wdasilvamf/Vocalizador/FinalReport-BrailleVocalizerKebyboard.pdf

Braille vocalization keyboard

Wanderson da Silva Maciel Filho, Maurílio Nunes Vieira
Departamento de Eletrônica/Escola de Engenharia/UFMG - Brazil
Beatriz Fonseca Torres, Regina Célia Passos Ribeiro de Campos
Faculdade de Educação/UFMG - Brazil

### 1. Introduction

This report describes the development of the prototype of a keyboard to aid the literacy of a visually impaired child. One goal is the learning of the Braille symbols for letters and numbers. The user is enrolled in a class with students without visual loss and another goal is the inclusion of the disabled in this class. For this, the keyboard allows not only the sound reproduction of the characters but also the registration and visualization of keystrokes typed for accompaniment of the teacher or of the colleagues (Figure 1).

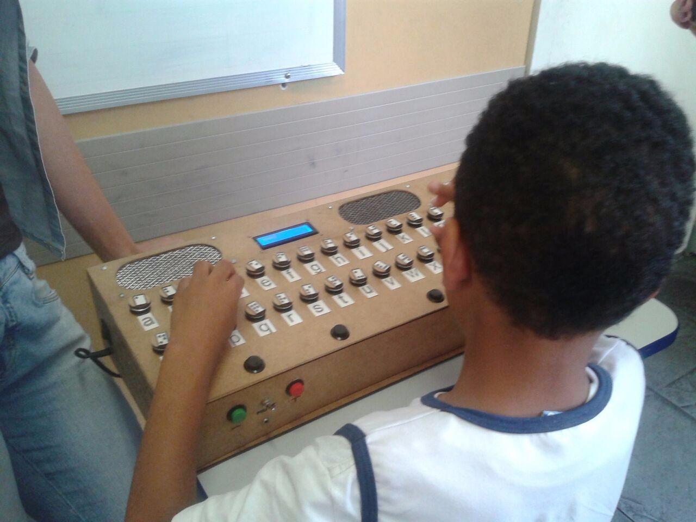
[picture p1: figure]

Figure 1: Visually impaired child using the prototype.

Figure 2 shows details of the prototype. The keys are arranged alphabetical group and numeric groups. Wooden circles with the Braille symbols were glued over the keys. There are two loudspeakers (SP1 and SP2), a liquid crystal display (LCD) and switches to mute and adjust the volume (Vol- and Vol +). The user can also hear the sound of the letters through a headset whose connector is below the mute key. The four black circular buttons on the bottom (unidentified) are reserved for future improvements of the prototype.

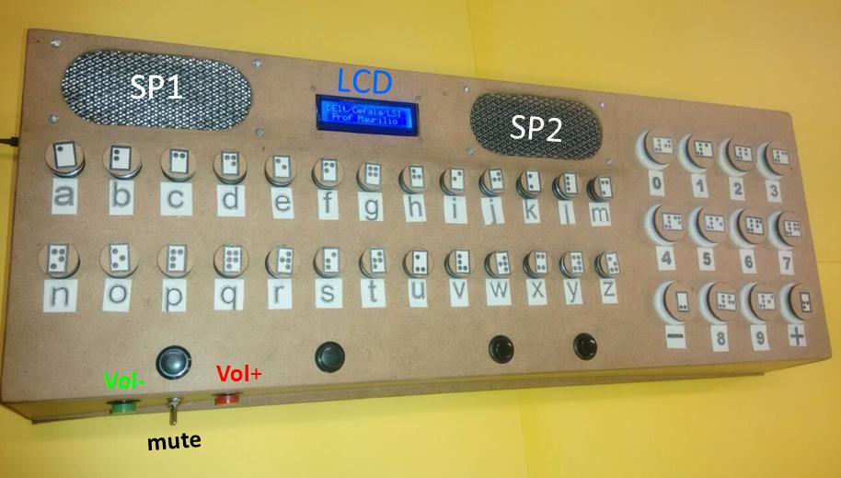
[picture p2: figure]

Figure 2: User interface aspects of the prototype. See details in the text.

Figure 3 presents the inside of the keyboard, highlighting the LDC i2c controller board, the power supplies (AC/DC), and the main control board. This version of the keyboard does not use batteries.

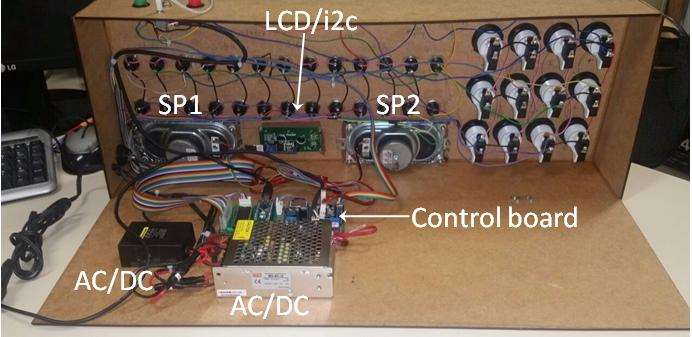
[picture p3: figure]

Figure 3: Interior of the prototype. See text for details.

Figure 4 shows the control board and its main components: the Arduino Nano, the keyboard decoder (CD 4515), the audio processor (DfPlayer mini), and the power amplifier (Pam 8610). Keyboard decoding could have been implemented with obsolete PS2 serial keyboard controllers, but the lack of standardization in the layout of the keyboard matrices motivated the use of a circuit based of the CD 4515, a 4 to 16 decoder.

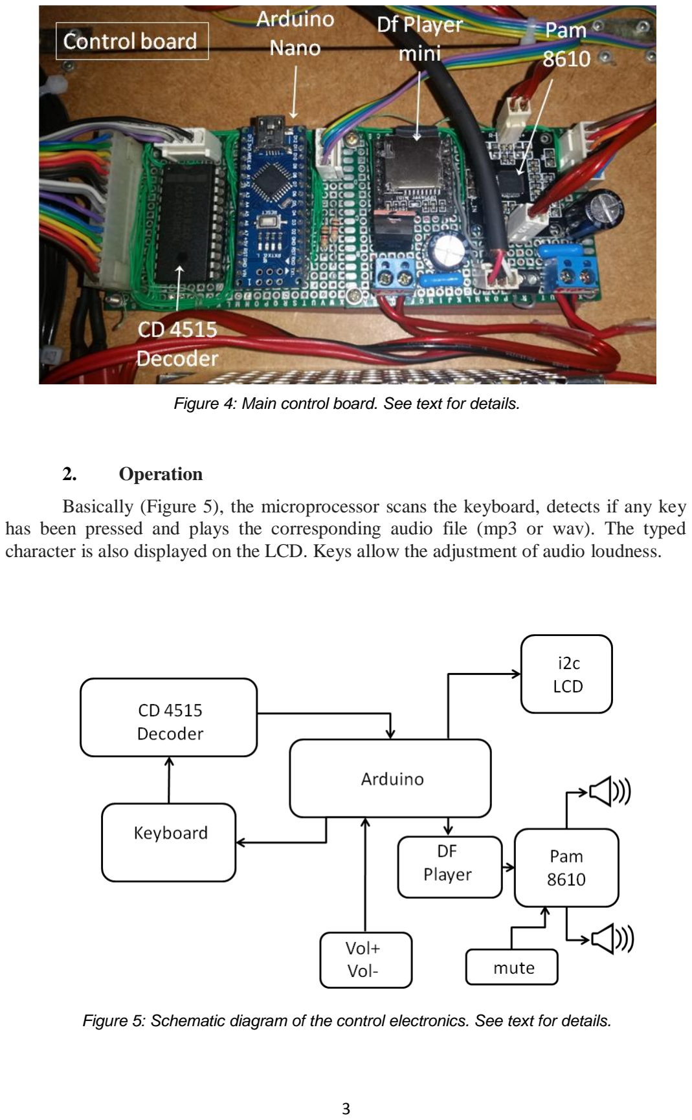
[picture p4: page 3]

Figure 4: Main control board. See text for details.

### 2. Operation

Basically (Figure 5), the microprocessor scans the keyboard, detects if any key has been pressed and plays the corresponding audio file (mp3 or wav). The typed character is also displayed on the LCD. Keys allow the adjustment of audio loudness.

Figure 5: Schematic diagram of the control electronics. See text for details.

### 3. Main control board

### 3.1. Hardware

The schematic diagram of the control board is shown in Figure 6. U2 (Arduino Nano) does the main control of functions. U1 (CD4515) decodes the 4 binary addressing lines (Arduino digital outputs D8 ... D11) into up to 16 individual drive lines (Y0 ... Y15). In the project, 14 outputs (Y0 ... Y13) are used, each line addressing a 3-key group. In this way, Y0 addresses keys A, B or C; Y1 addresses keys D, E, or F, and so on. All alphanumeric keys have momentary contact. The 3-key groups are interconnected by the return lines (Ret1, Ret2 and Ret3), as shown in the schematic diagram. These return lines are Arduino digital inputs that allow the detection, by software, of the key activated in the respective 3-key group.

Once a pressed key is detected, the Arduino software will control the playback of the
audio | files | and | the | display | of | the | characters | on | the | LCD.
A code will be sent to DFPlayer to reproduce the respective file. All audio files have been previously recorded, edited and stored on a MicroSD card housed in the DFPlayer. For complete playback control, volume control functions were performed on Arduino and not using the DFPlayer pins. Audio signals in DFPlayer output have adequate power for earphones, which can be connected to J1, but require amplification for playback on loud speakers so that all students in the class room listen to the sound. This amplification is performed by Pam8610, a 15 W per channel stereo class D amplifier. It was necessary isolated the power supply (12 V × 5 A) of this amplifier to avoid interference with other circuits. Attempts to use filters, etc., were not successful to avoid crosstalk noise. The 9 V × 1 A power source is connected to Arduino, which, in turn, powers the CD451 through the + 5V output. The 9V power source is also connected to U3 (LM 7805 regulator) to provide 5V x 1A (+ 5Vpwr) for the LCD display and the DFPlayer.

Arduino also control the display of characters on the LCD (16 columns x 2 lines). This allows the teacher or colleagues to follow the actions of the user.

3.2.Software

The comments in the source code, attachment, give the details of the hardware control, links to libraries, etc. Direct access to the microprocessor ports (PORTB) resulted in a compact code. The keys are addressed through variables alfabeto [][] and Order [][], which include other keys (ENT, SPC, DEL, ?) aimed at text edition. In the future, resources can be developed to aid to writing learning, such as the management of playing syllables, words, etc.

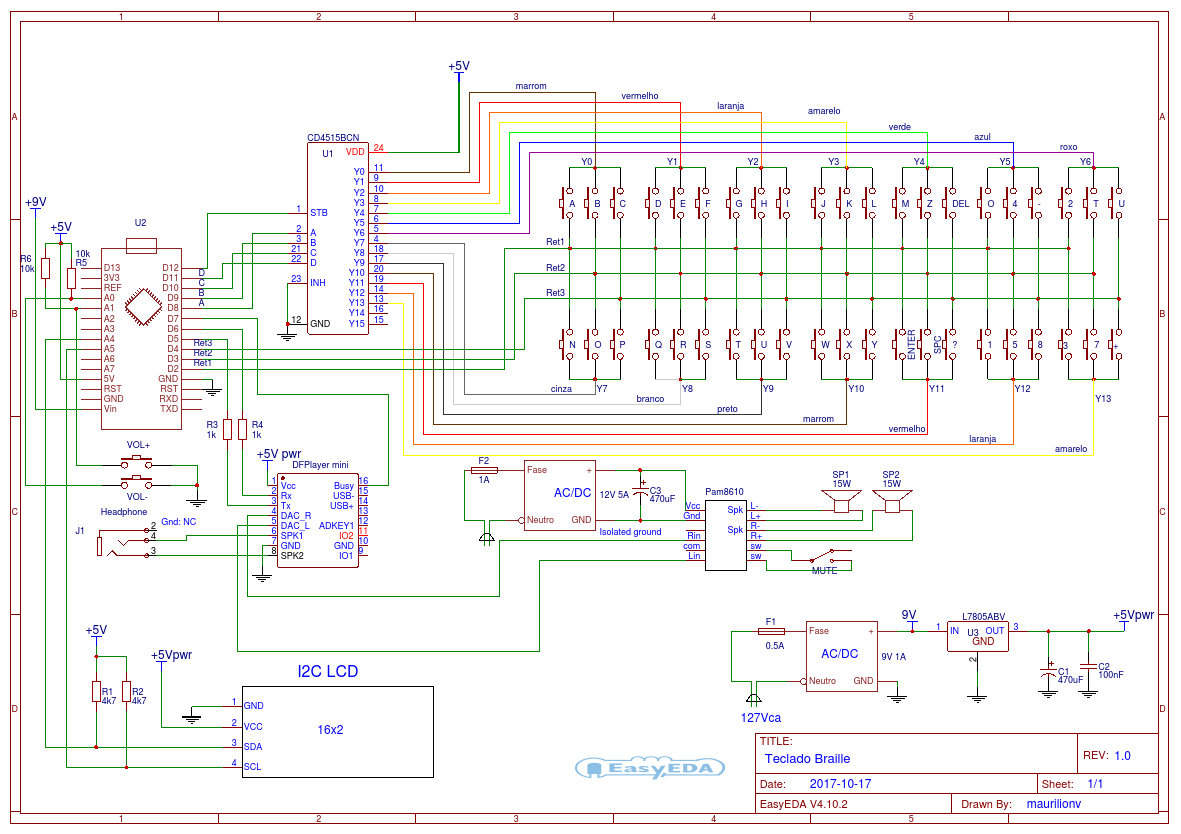
[picture p5: page 5]

5

Figure 6: Detailed schematic diagram

### 4. Source code

Available from

https://drive.google.com/open?id=1iKNauiLZP-CNw-wMV79ck8yiDLUtnyXp

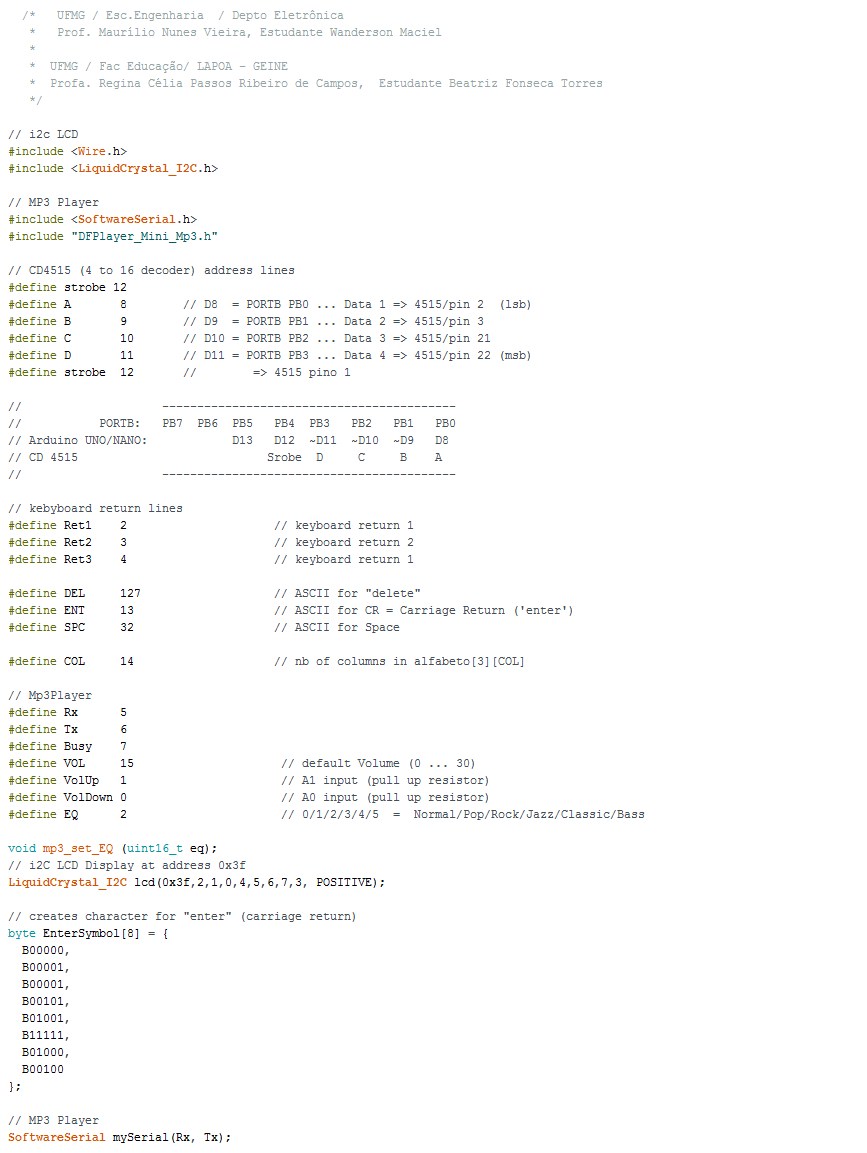
[picture p6: figure]
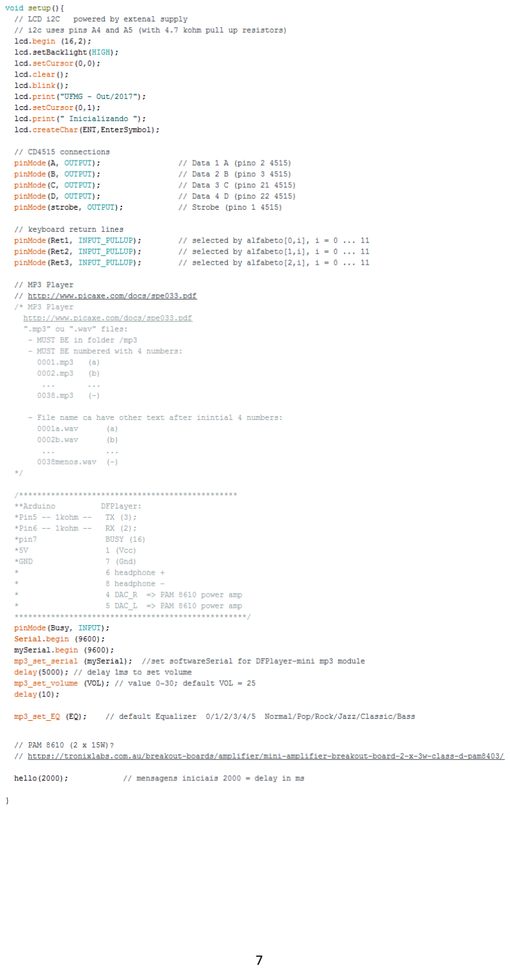
[picture p7: page 7]
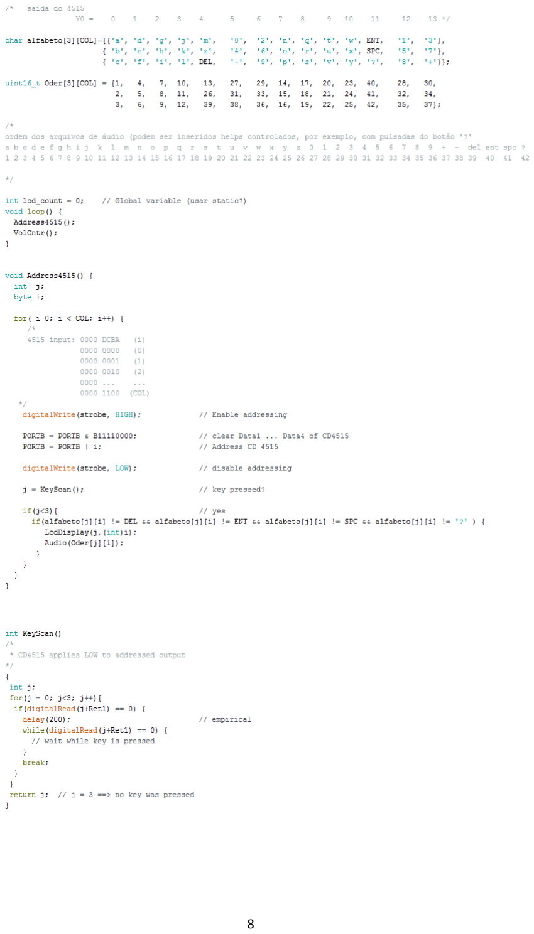
[picture p8: page 8]

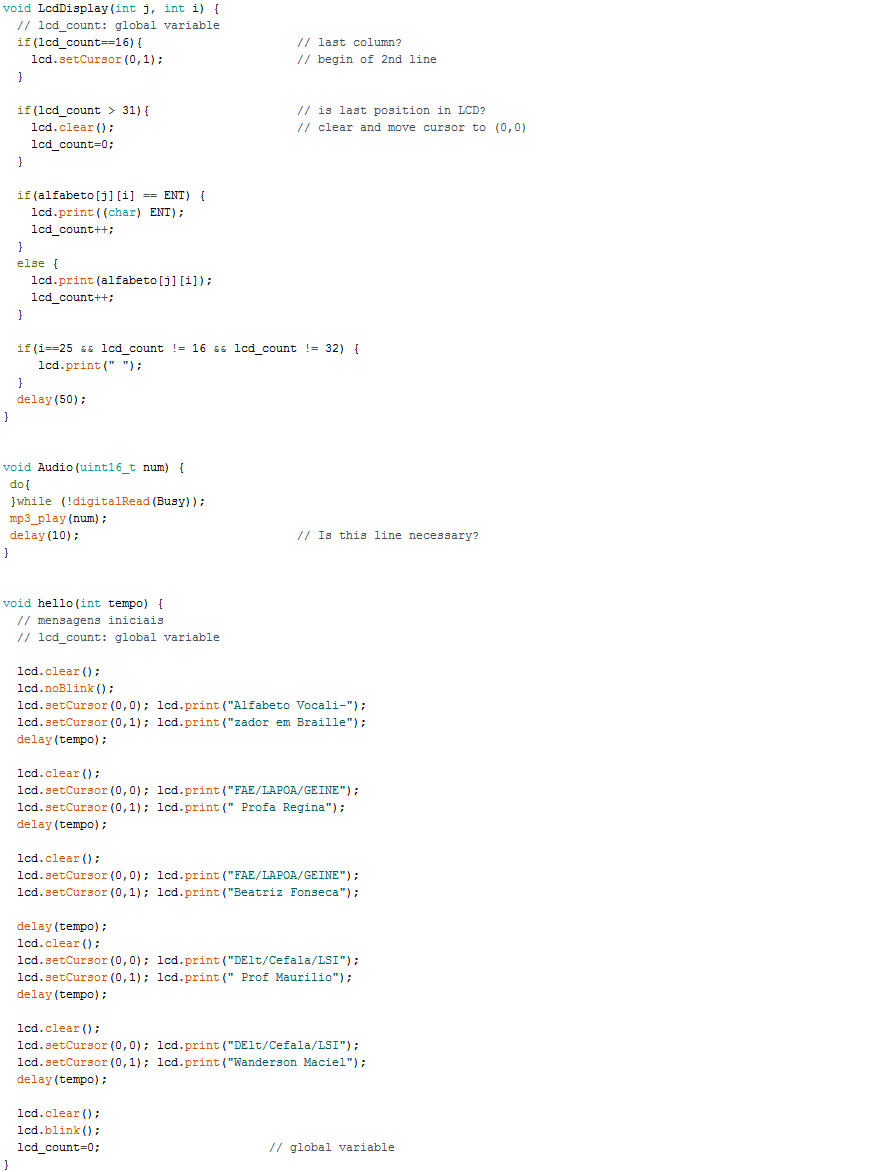
[picture p9: figure]

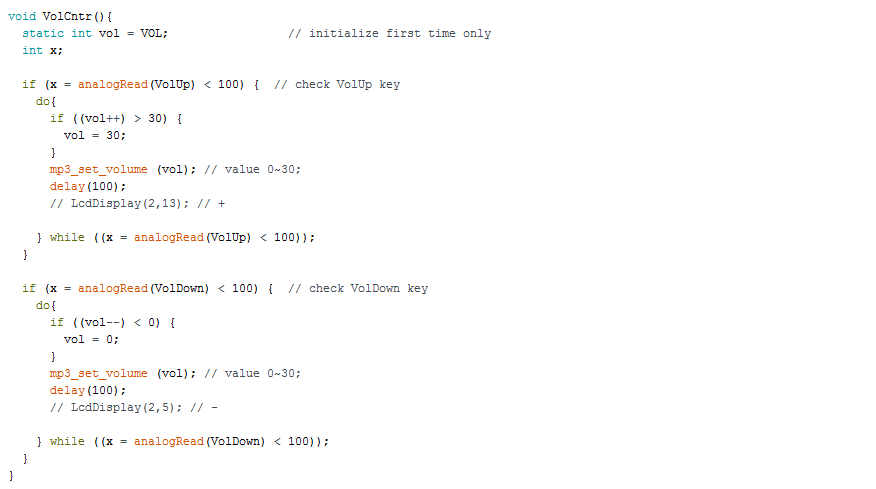
[picture p10: figure]
