wdasilvamf/Vocalizador/RelatorioFinal-vocalizador.pdf

UNIVERSIDADE FEDERAL DE MINAS GERAIS

Teclado Vocalizador Braille

Escola de Engenharia / Depto Eletrônica

LSI - Laboratório de Sistemas Inteligentes

CEFALA – Centro de Estudos da Fala, Música e Linguagem

Estudante Wanderson da Silva Maciel Filho

Prof. Maurílio Nunes Vieira

Faculdade de Educação

LAPOA - Laboratório Interdisciplinar de Produção de Objetos de

Aprendizagem para a pessoa com deficiência

GEINE - Grupo Interdisciplinar de Estudos sobre Educação Inclusiva e

Necessidades Educacionais Especiais

Estudante Beatriz Fonseca Torres

Profa. Regina Célia Passos Ribeiro de Campos

### 1. Introdução

Este trabalho descreve o desenvolvimento do protótipo de um teclado

para auxílio à alfabetização de uma criança com deficiência visual. O objetivo é

o aprendizado dos símbolos Braille para as letras e números. O usuário está

matriculado numa classe com alunos sem perda visual e outra meta é a

inclusão do deficiente nesta classe. Para isso, o teclado permite não só a

sonorização dos caracteres como também o registro e visualização de teclas

digitadas para acompanhamento do professor ou dos colegas (Figura 1).

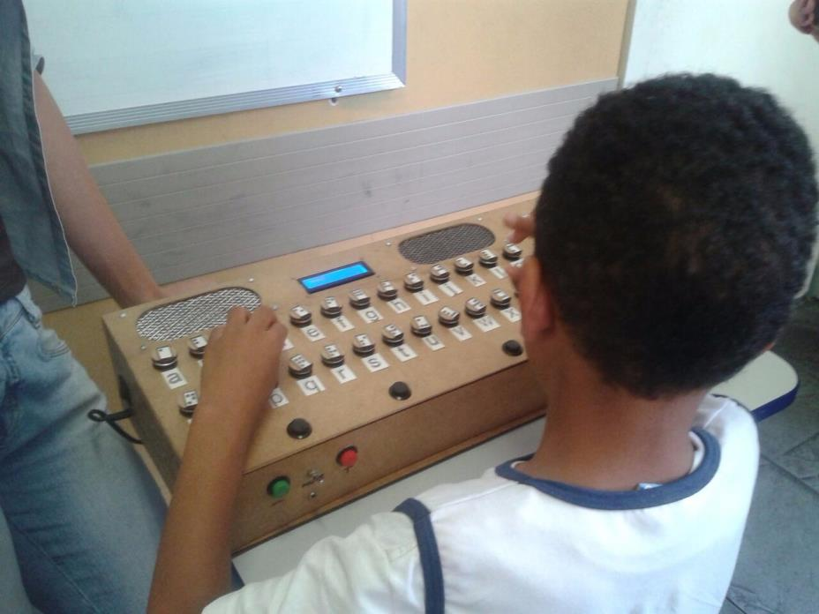
[picture p11: figure]

Figura 1: Estudante deficiente visual utilizando o protótipo.

A figura 2 mostra detalhes do protótipo. As teclas estão dispostas em

um grupo alfabético e outro numérico. Círculos de madeira com os símbolos

Braille foram colados sobre as chaves. Há dois alto-falantes (SP1 e SP2), um

display de cristal líquido (LCD) e chaves para ligar/desligar os alto-falantes

(mute) e ajustar o volume sonoro (Vol- e Vol+). O usuário também pode ouvir o

som das letras por meio de um fone de ouvidos, cujo conector está abaixo da

chave mute. As quatro teclas circulares pretas na parte inferior (não

identificadas) são reservadas para uso futuro na fase de aquisição da escrita.

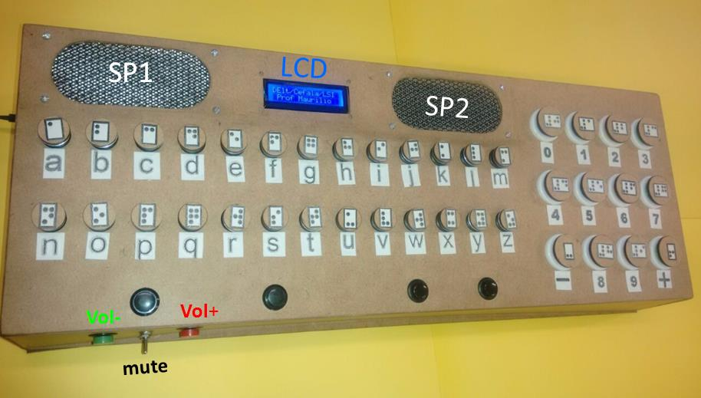
[picture p12: figure]

Figura 2: Visualização do exterior do protótipo. Ver detalhes no texto.

A Figura 3 mostra o interior do teclado onde estão a placa i2c controladora do

display LCD, as fontes de alimentação (AC/DC) e a placa de controle principal.

Esta versão do teclado não permite a utilização de baterias.

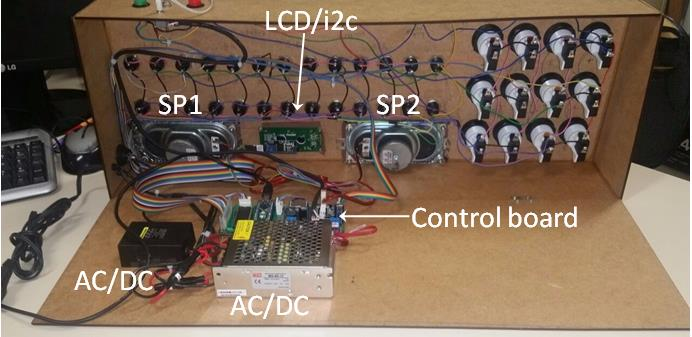
[picture p13: figure]

Figura 3: Visualização do interior do protótipo. Ver detalhes no texto.

A figura 4 mostra a placa de controle e seus componentes principais: Arduino

Nano, decodificador do teclado (CD 4515), leitor/reprodutor de gravações de

áudio (DfPlayer mini) e amplificador de potência (Pam 8610). A decodificação

do teclado poderia ter sido feita usando o hardware de teclados seriais PS2, obsoletos, mas a falta de padronização no layout das matrizes destes teclados

motivou a utilização de um circuito baseado do circuito integrado CD 4515, um

decodificador de 4 para 16 linhas.

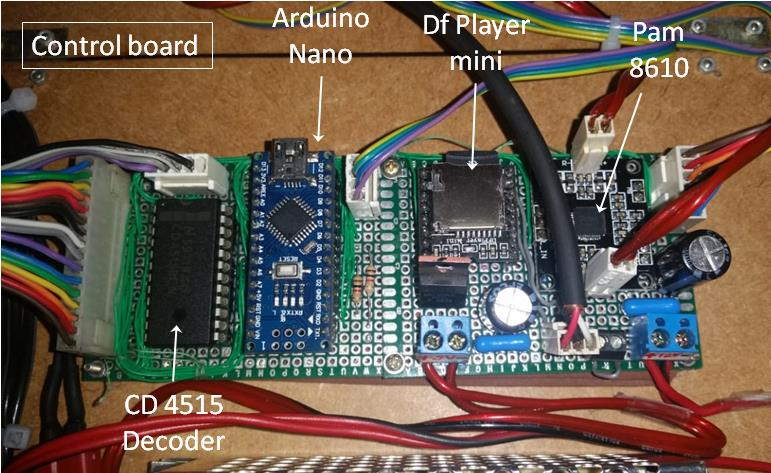
[picture p14: figure]

Figura 4: Placa de controle. Ver detalhes no texto.

### 2. Funcionamento

Basicamente (Figura 5), o microprocessador faz uma varredura do

teclado, detecta se alguma tecla foi pressionada e reproduz o sinal de áudio

(mp3 ou wav) correspondente. A letra correspondente também é registrada no

display LCD. Chaves também permitem ajustar o nível do sinal de áudio.

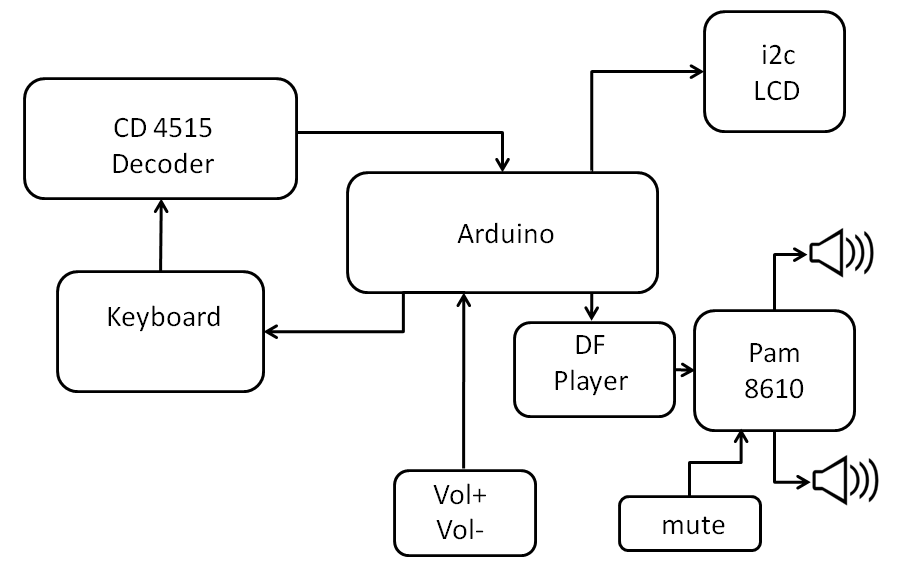
[picture p15: figure]

Figura 5: Diagrama esquemático da eletrônica de controle. Ver detalhes no texto.

### 3. Placa de controle

### 3.1. Hardware

O diagrama esquemático da placa controladora é apresentado na Figura 6.

U2 é o Arduino Nano que faz o controle principal das funções. U1 é o circuito

integrado CD4515 que decodifica 4 linhas de endereçamento binário (saídas

digitais D8…D11 do Arduino) em até 16 linhas de acionamento individual

(Y0…Y15). No projeto, são usadas 14 saídas do CD4515 (Y0…Y13), cada uma

endereçando um grupamento de 3 chaves. Desta forma, a saída Y0 endereça

as chaves das teclas A, B ou C; a saída Y1 endereça as teclas D, E ou F; e

assim sucessivamente. Todas as teclas alfanuméricas são de contato

momentâneo. Os grupos de três teclas estão interligados pelos sinais de

retorno (Ret1, Ret2 e Ret3) de forma a permitir a detecção de qual tecla está

acionada no grupo. As linhas de retorno correspondem a entradas digitais do

Arduino. Em síntese, a detecção é feita com o endereçamento, por software,

dos grupos de 3 teclas (Y0…Y13) seguida pela identificação da linha de retorno

ativada em cada grupo.

Uma vez detectada a tecla, o software no Arduino fará o controle da

reprodução do áudio e da escrita no display LCD. Será enviado um código ao

DFPlayer que reproduz o arquivo correspondente ao nome da letra,

previamente gravado, editado e armazenado em um cartão MicroSD alojado no

DFPlayer. Para melhor controle da reprodução, as funções de controle de

volume foram executadas no Arduino e não nos pinos do DFPlayer. O sinal de

áudio na saída do DFPlayer tem potência adequada para uso em microfone

(que pode ser conectado em J1), mas requer amplificação para reprodução em

alto-falantes para que todos os estudantes ouçam. Esta amplificação é

realizada pelo Pam8610, um amplificador classe D estéreo de 15 W por canal.

Foi necessário o uso de uma fonte de alimentação isolada (12 V x 5 A) para

este amplificador para evitar interferências com outros circuitos. A fonte de 9 V

x 1 A alimenta o Arduino que, por sua vez, alimenta o CD4515, de tecnologia

CMOS, pelo saída +5V. O circuito integrado U3 é o regulador 7805 que fornece

5 V x 1 A (+5Vpwr) para o display LCD e do DFPlayer.

O software gerencia a escrita das letras no display LCD (16 colunas x 2

linhas). Este registro permite que o professor ou colegas acompanhem as


7

Figura 6: Esquemático do circuito eletrônico ações do usuário do teclado. No futuro, quando o estudante estiver na fase de

aquisição da escrita, poderão ser desenvolvidos recursos para auxílio à escrita,

incluindo a reprodução sílabas, palavras, etc.

3.2.Software

Os comentários no código fonte, anexo, dão os detalhes do controle do

hardware, links para bibliotecas, etc. O acesso direto às portas do

microprocessador (PORTB) resultou em um código compacto. As teclas são

endereçadas através das variáveis alfabeto[][] e Order[][], que já prevêem

quatro teclas reserva (ENT, SPC, DEL, ?).

### 4. Desafios enfrentados

Na tentativa de realizar um projeto conciso e compacto, foram buscadas

alternativas para se escrever um código que pudesse ser o mais sucinto

possível. A melhor opção encontrada foi o uso do endereçamento PORTB para

a leitura das teclas. Ao se tratar disso, é destacável o desafio de encarar uma

forma de programação que não fora utilizada antes.

Ademais, sabe-se que sinais analógicos sofrem muito ruídos externos

que apresentam diversas fontes. Isso se intensifica quando se trata de um

projeto de baixo investimento como esse. Dessa forma, ao tentar reproduzir os

áudios MP3 concluímos que a qualidade era baixa devido a algum tipo de

interferência. Ao investigar de onde poderia estar vindo a distorção do sinal foi

melhorada a qualidade da gravação do arquivo, refeita as conexões a fim de

evitar mau contato, alterada a intensidade dos alto falantes, mas o que resultou

em uma melhora eficaz na reprodução do áudio foi a inserção de uma fonte de

tensão exclusiva para o circuito de áudio. A conclusão que é retirada desta

solução é a existência de algum tipo de sinal que chegava aos alto falantes por

meio do terminal negativo que era interligado por todo o circuito.

Por fim, pode-se citar a dificuldade na construção de uma placa

projetada em softwares de design. Existe a dificuldade de representar a

variedade de módulos que o circuito apresenta. A partir disso, foi escolhida a

construção da placa de forma manual, já que o tempo para a conclusão do

projeto era curto.

### 5. Possíveis melhorias

Como o objetivo dessa primeira abordagem era apenas um protótipo do

vocalizador, claramente existem pontos a serem melhorados até que se

chegue num produto final que corresponda com todas as expectativas. A seguir

pode-se conferir uma lista de pontos que devem ser considerados nos futuros

protótipos:

- Compactação da estrutura de forma que ofereça maior

confiabilidade mecânica e praticidade para o aparelho.

- Concepção da placa por via de software, a fim de padronizar a

construção e fácil substituição

- Inserção de um sinal sonoro indicando para o usuário que o

aparelho está pronto para utilização após ser iniciado. O mesmo serve para o

momento em que o aparelho for desligado.

- Adicionar uma função para que além do aparelho representar

letras e números ele seja capaz de representar sílabas e pequenas palavras. O

mesmo pensamento pode ser aplicado quando se trata dos números e

operações simples (soma, subtração, multiplicação e divisão).

- Tornar o aparelho portátil, através de uma bateria que possa ser

recarregada e apresenta uma autonomia interessante.

### 6. Conclusão

Portanto, a partir do que foi apresentado, pode-se constatar que

pequenas aplicações da engenharia são o suficiente para facilitar a vida do ser

humano, principalmente daqueles portadores de deficiência física. Esse

protótipo foi testado com alunos e apresentou uma alternativa aos professores

no momento de ensinar a linguagem Braille.

Além disso, vale ressaltar que o protótipo cumpriu com o propósito de

validar a ideia inicial que, a partir de agora, pode ser otimizada a fim de tornar

sua utilização mais impactante na educação dos deficientes visuais.

### 7. Apêndice: Código fonte

Disponível em:

https://drive.google.com/open?id=1iKNauiLZP-CNw-wMV79ck8yiDLUtnyXp

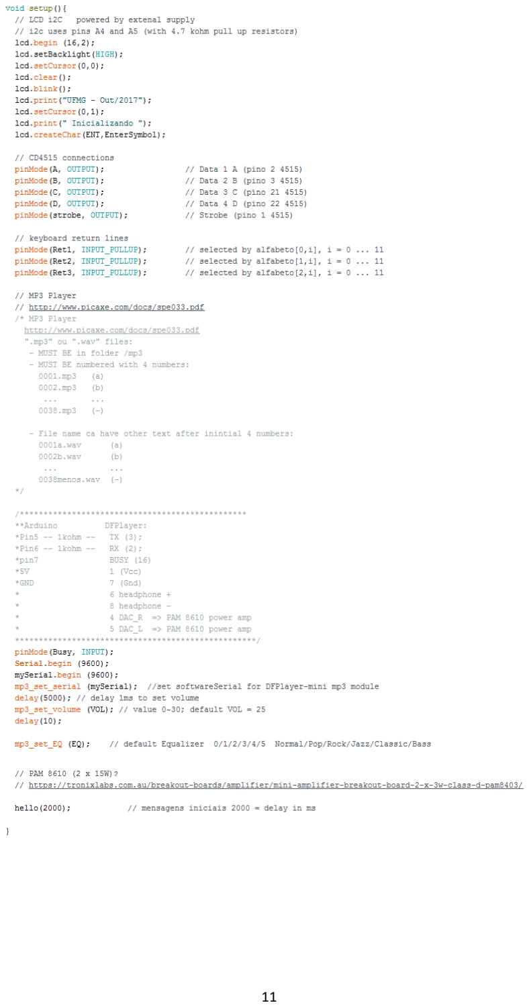
[picture p16: page 11]
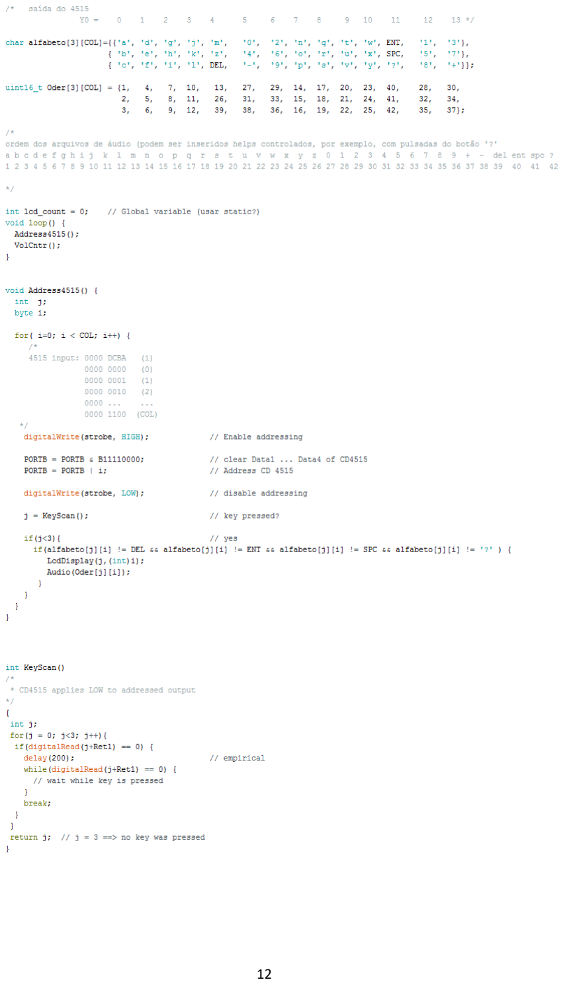
[picture p17: page 12]
